XFJ-YYQF/Sleepy-Widget/v0.4 PCB/PCB_PCB_Sleepy-Widget_2026-07-19.png

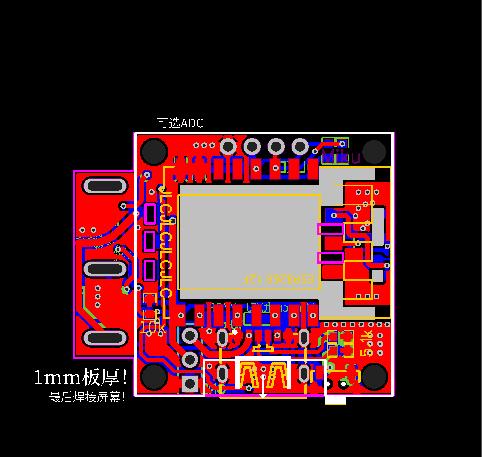
v0.4 PCB/PCB_PCB_Sleepy-Widget_2026-07-19.png
