XFJ-YYQF/Sleepy-Widget/(list of files, drawings)

Other design files:
v0.2 PCB/PCB_PCB_Sleepy-Widget_2026-06-09.json
v0.3 PCB/PCB_PCB_Sleepy-Widget_2026-06-14.json
v0.4 PCB/PCB_PCB_Sleepy-Widget_2026-07-19.json
