XFJ-YYQF/Sleepy-Widget/(commit log)

2026-06-09 更新固件，上传v0.2 PCB
    慢服务器：请求耗时 4s，下一次从完成时起再等 15s
    息屏状态：每 60s 才查一次，减少流量和服务器压力
    出错状态：每 30s 重试一次
    按键/外部状态变化唤醒屏幕时：立即刷新一次
    [PCB_PCB_Sleepy-Widget_2026-06-09.json]
2026-06-14 更新PCB
    1.移动了AMS1117的位置（以前会和模块打架）
    2.移动了副板的位置，方便剪下来和生产
    3.修复了封装错误的按键
    [PCB_PCB_Sleepy-Widget_2026-06-14.json]
2026-07-19 更新最终PCB（可能吧
    [PCB_PCB_Sleepy-Widget_2026-07-19.json]
2026-07-19 Revise README for PCB version and firmware updates
    Updated README to reflect PCB version and firmware status.
